l0ud/LooTunes/assets/assembled_pcb.jpg

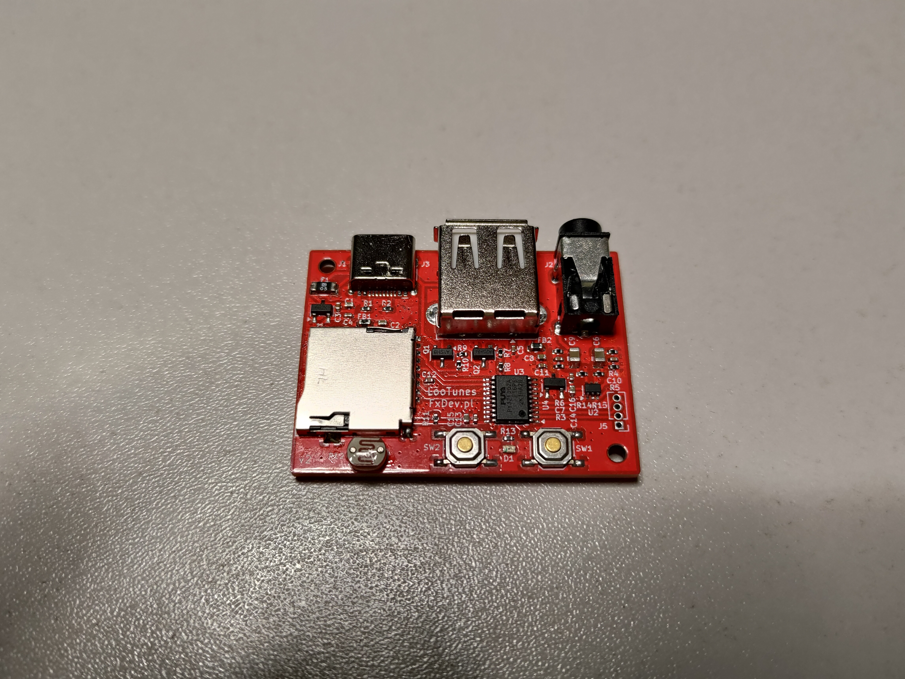
assets/assembled_pcb.jpg
