l0ud/LooTunes/assets/case.jpg

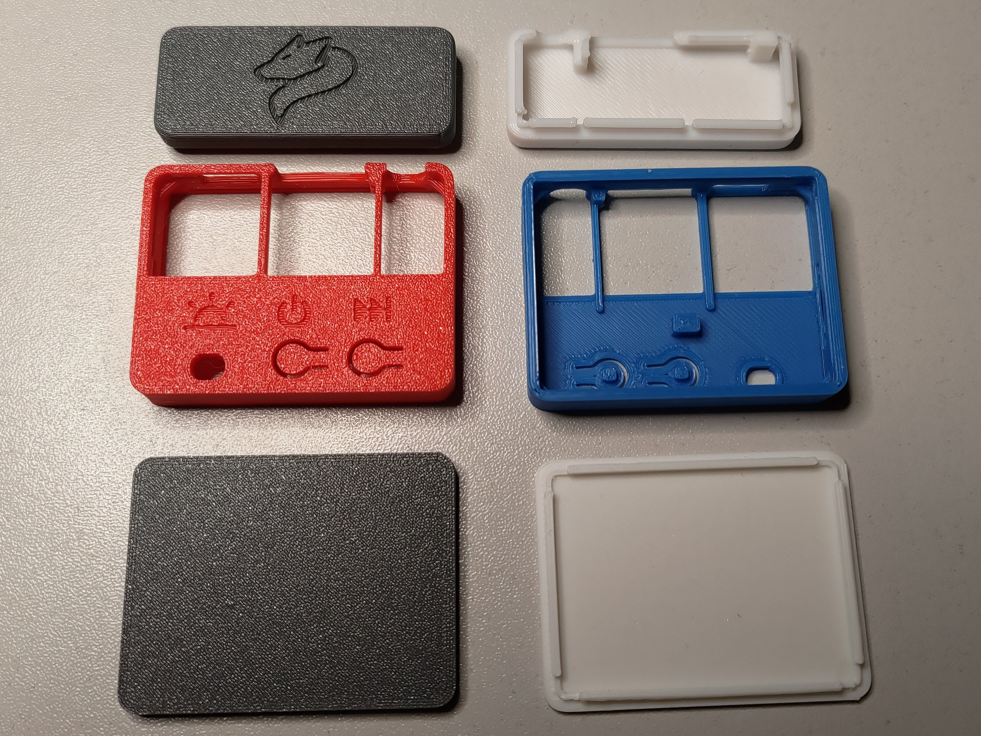
assets/case.jpg
