l0ud/LooTunes/assets/device.jpg

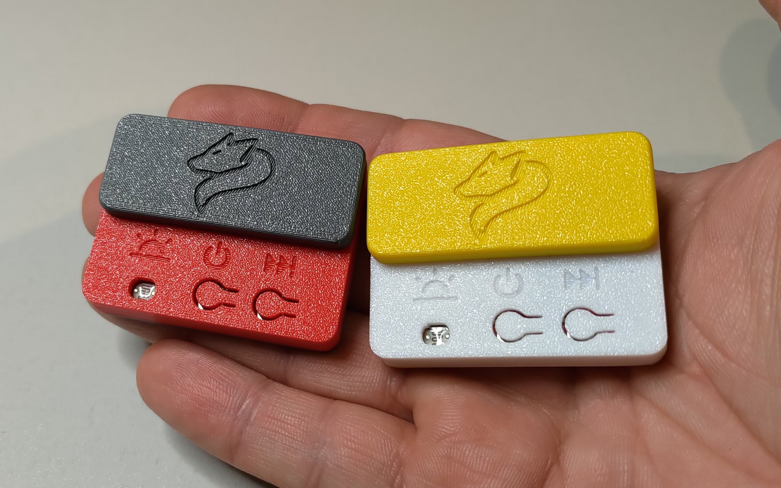
assets/device.jpg
