l0ud/LooTunes/assets/devices.jpg

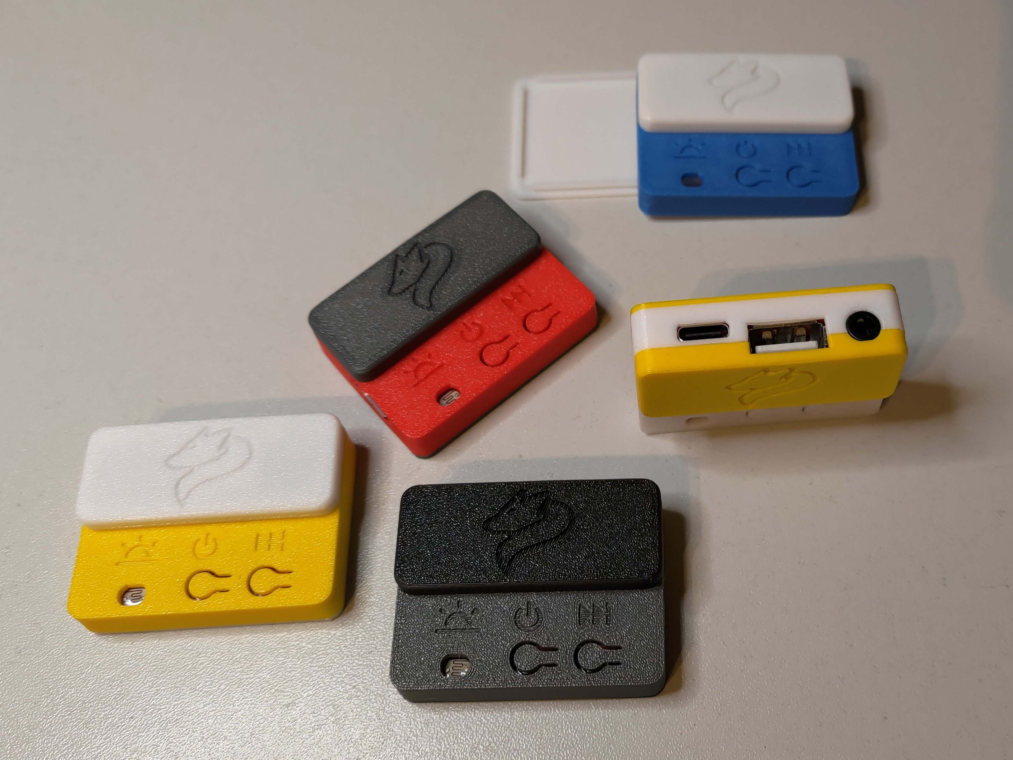
assets/devices.jpg
