l0ud/LooTunes/assets/pcb.jpg

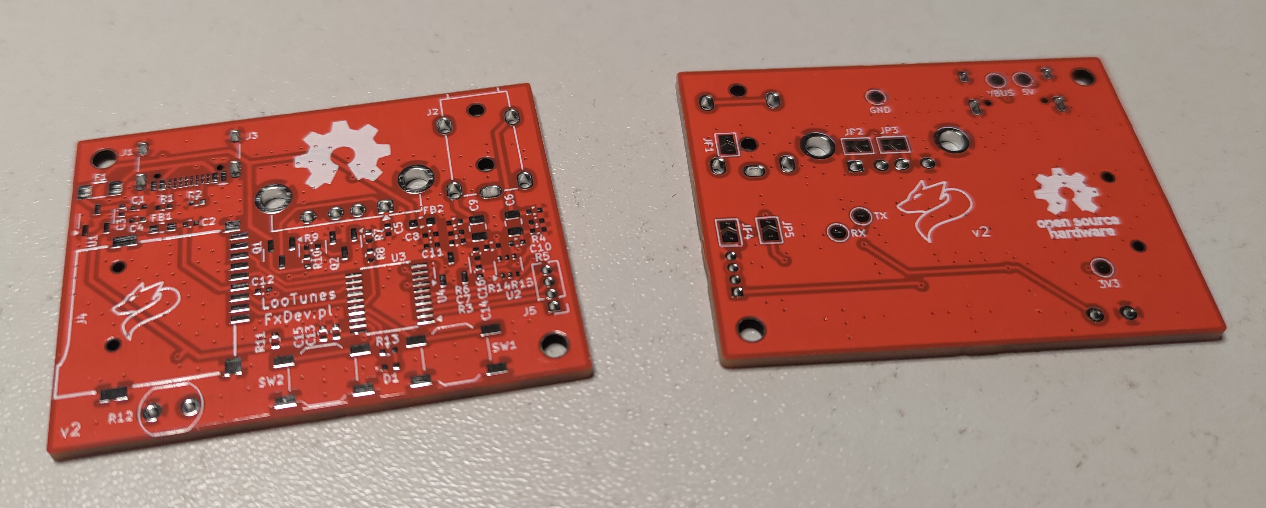
assets/pcb.jpg
