l0ud/LooTunes/assets/pcb_placed.jpg

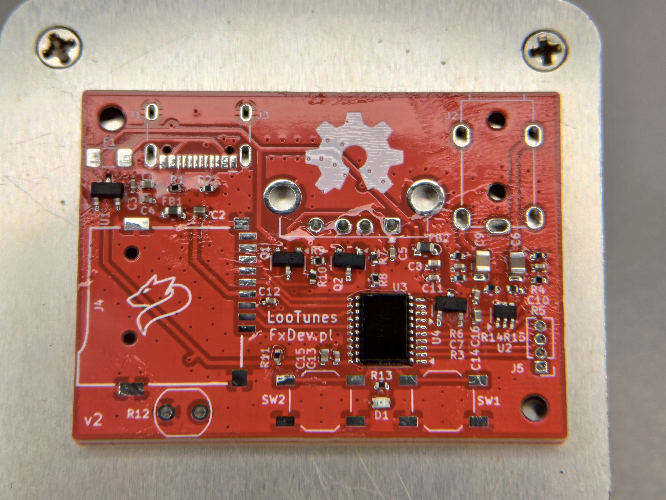
assets/pcb_placed.jpg
