l0ud/LooTunes/assets/pcb_tinned.jpg

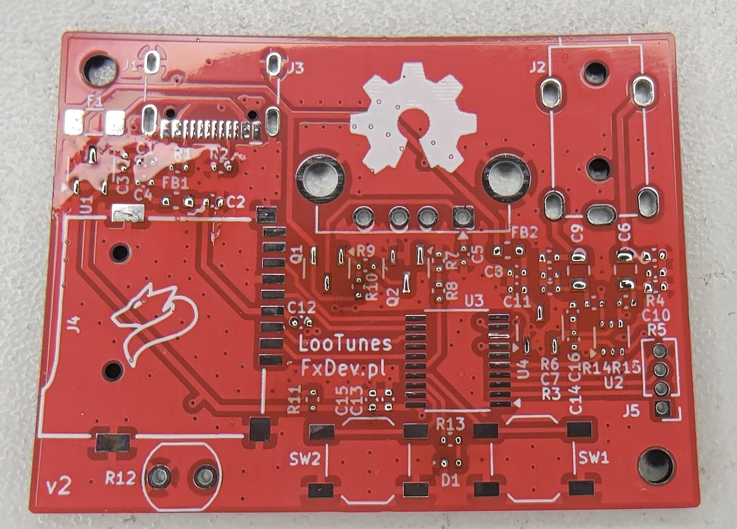
assets/pcb_tinned.jpg
