l0ud/LooTunes/assets/with_speakers.jpg

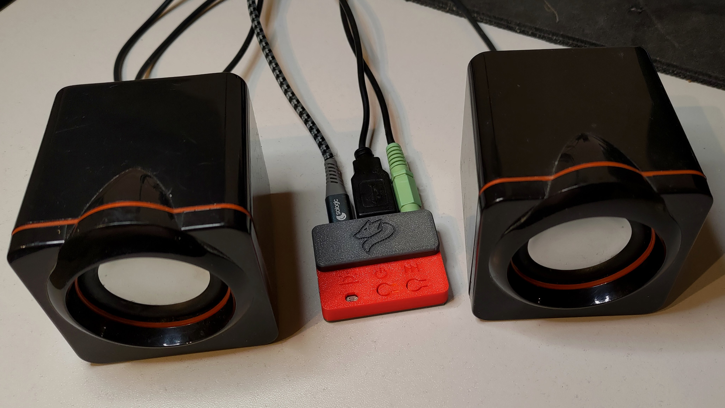
assets/with_speakers.jpg
