l0ud/LooTunes/case/base.stl

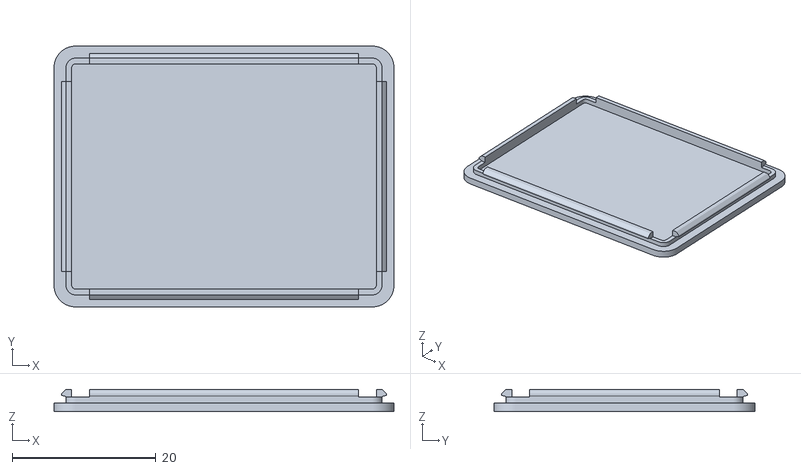
[picture p9: CAD file, 2025-11-18]
case/base.stl
47.3 x 36.3 x 3.09
