l0ud/LooTunes/case/body.stl

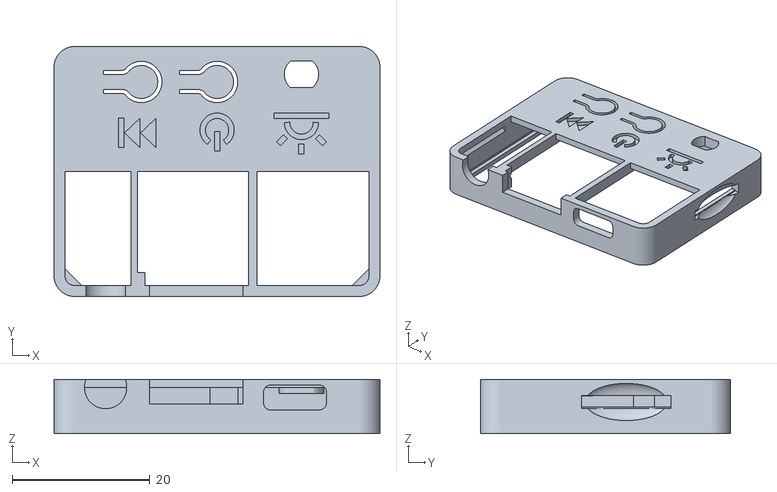
[picture p10: CAD file, 2025-11-18]
case/body.stl
47.3 x 36.3 x 7.88
