l0ud/LooTunes/case/cap.stl

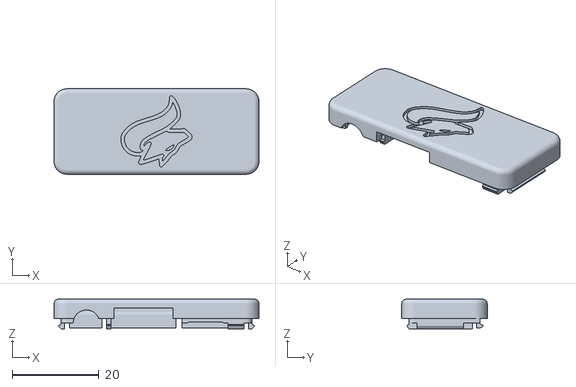
[picture p11: CAD file, 2025-11-18]
case/cap.stl
47.3 x 19.8 x 6.86
