l0ud/LooTunes/assets/schematics.pdf

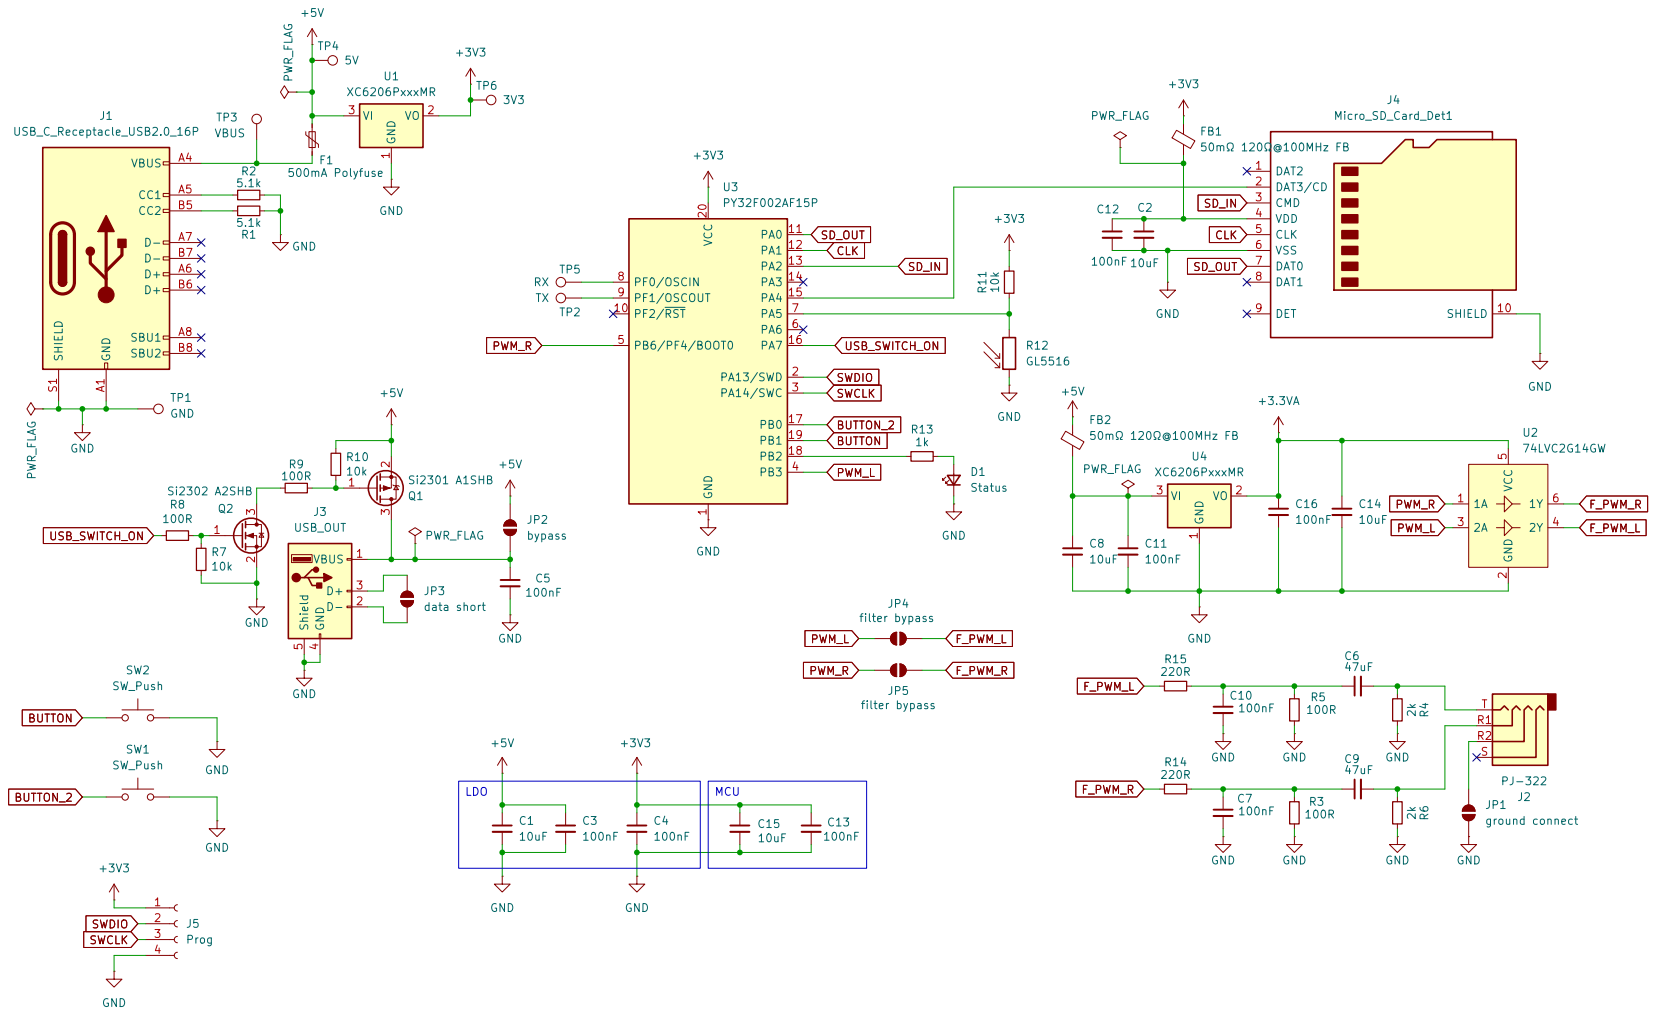
[picture p12: page 1]
