l0ud/LooTunes/hardware/FxLooTunes.kicad_pcb

## KiCad design hardware/FxLooTunes.kicad_pcb (2025-10-19)

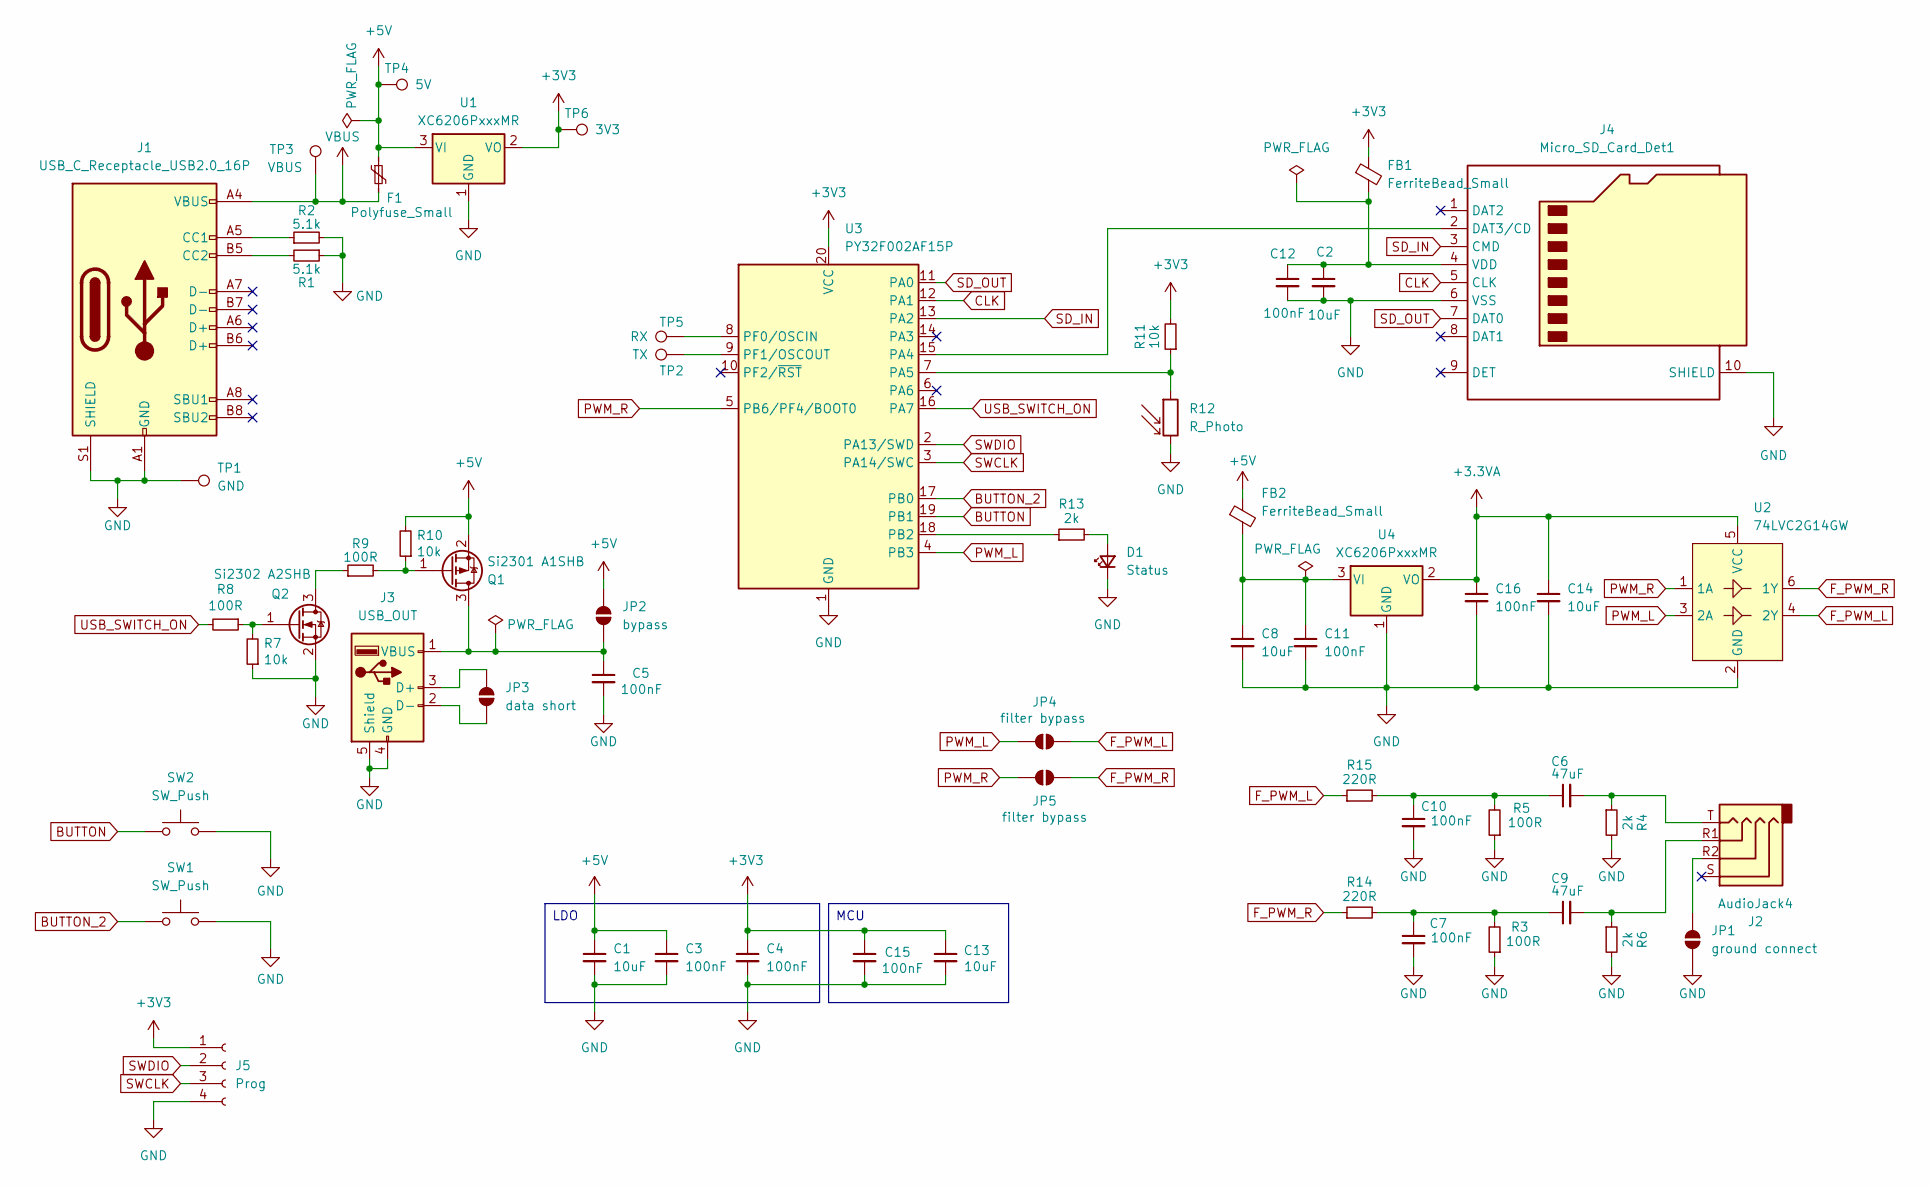
[picture p13: schematic FxLooTunes.kicad_sch]

Parts:
C1, C2, C8, C13, C14: 10uF; C_0402_1005Metric
C3, C4, C5, C7, C10, C11, C12, C15, C16: 100nF; C_0402_1005Metric
C6, C9: 47uF; C_0805_2012Metric
D1: Status; LED_0402_1005Metric
F1: Polyfuse_Small; Fuse_1206_3216Metric
FB1, FB2: FerriteBead_Small; L_0603_1608Metric
J1: USB_C_Receptacle_USB2.0_16P; USB_C_Receptacle_HCTL_HC-TYPE-C-16P-01A
J2: AudioJack4; PJ-322
J3: USB_OUT; USB_A_Connfly_DS1095
J4: Micro_SD_Card_Det1; GCT-MEM2055-00-190-01-A
J5: Prog; PinHeader_1x04_P1.27mm_Vertical
JP1: ground connect; SolderJumper-2_P1.3mm_Open_TrianglePad1.0x1.5mm
JP2: bypass; SolderJumper-2_P1.3mm_Open_TrianglePad1.0x1.5mm
JP3: data short; SolderJumper-2_P1.3mm_Open_TrianglePad1.0x1.5mm
JP4, JP5: filter bypass; SolderJumper-2_P1.3mm_Open_TrianglePad1.0x1.5mm
Q1: Si2301 A1SHB; SOT-23
Q2: Si2302 A2SHB; SOT-23
R1, R2: 5.1k; R_0402_1005Metric
R3, R5, R8, R9: 100R; R_0402_1005Metric
R4, R6, R13: 2k; R_0402_1005Metric
R7, R10, R11: 10k; R_0402_1005Metric
R12: R_Photo; R_LDR_5.0x4.1mm_P3mm_Vertical
R14, R15: 220R; R_0402_1005Metric
SW1, SW2: SW_Push; SW_SPST_TL3342
TP1: GND; TestPoint_Pad_D1.5mm
TP2: TX; TestPoint_Pad_D1.5mm
TP3: VBUS; TestPoint_Pad_D1.5mm
TP4: 5V; TestPoint_Pad_D1.5mm
TP5: RX; TestPoint_Pad_D1.5mm
TP6: 3V3; TestPoint_Pad_D1.5mm
U1, U4: XC6206PxxxMR; SOT-23-3
U2: 74LVC2G14GW; SOT-363_SC-70-6
U3: PY32F002AF15P; TSSOP-20_4.4x6.5mm_P0.65mm

Connections:
+3.3VA: C14.1, C16.1, U2.5 (VCC), U4.2 (VO)
+3V3: C4.1, C13.1, C15.1, FB1.1, J5.1, R11.2, TP6.1, U1.2 (VO), U3.20 (VCC)
BUTTON: SW2.1, U3.19 (PB1)
BUTTON_2: SW1.1, U3.17 (PB0)
CLK: J4.5 (CLK), U3.12 (PA1)
F_PWM_L: JP4.2 (B), R15.1, U2.4 (2Y)
F_PWM_R: JP5.2 (B), R14.1, U2.6 (1Y)
GND: C1.2, C2.2, C3.2, C4.2, C5.2, C7.2, C8.2, C10.2, C11.2, C12.2, C13.2, C14.2, C15.2, C16.2, D1.1 (K), J1.A1 (GND), J1.A12 (GND), J1.B1 (GND), J1.B12 (GND), J1.S1 (SHIELD), J3.4 (GND), J3.5 (Shield), J4.6 (VSS), J4.10 (SHIELD), J5.4, JP1.2 (B), Q2.2 (S), R1.1, R2.2, R3.1, R4.2, R5.1, R6.2, R7.1, R12.2, SW1.2, SW2.2, TP1.1, U1.1 (GND), U2.2 (GND), U3.1 (GND), U4.1 (GND)
unnamed: C6.1, C10.1, R5.2, R15.2
unnamed: C6.2, J2.T, R4.1
unnamed: C7.1, C9.1, R3.2, R14.2
unnamed: C9.2, J2.R1, R6.1
unnamed: D1.2 (A), R13.2
unnamed: J1.A5 (CC1), R2.1
unnamed: J1.B5 (CC2), R1.2
unnamed: J3.3 (D+), JP3.1 (A)
unnamed: J3.2 (D-), JP3.2 (B)
unnamed: J4.2 (DAT3/CD), U3.15 (PA4)
unnamed: C2.1, C12.1, FB1.2, J4.4 (VDD)
unnamed: J2.R2, JP1.1 (A)
unnamed: Q2.3 (D), R9.1
unnamed: Q2.1 (G), R7.2, R8.1
unnamed: Q1.1 (G), R9.2, R10.1
unnamed: R11.1, R12.1, U3.7 (PA5)
unnamed: R13.1, U3.18 (PB2)
unnamed: TP5.1, U3.8 (PF0/OSCIN)
unnamed: TP2.1, U3.9 (PF1/OSCOUT)
PWM_L: JP4.1 (A), U2.3 (2A), U3.4 (PB3)
PWM_R: JP5.1 (A), U2.1 (1A), U3.5 (PB6/PF4/BOOT0)
SD_IN: J4.3 (CMD), U3.13 (PA2)
SD_OUT: J4.7 (DAT0), U3.11 (PA0)
SWCLK: J5.3, U3.3 (PA14/SWC)
SWDIO: J5.2, U3.2 (PA13/SWD)
USB_SWITCH_IN: R8.2, U3.16 (PA7)
VBUS: F1.2, J1.A4 (VBUS), J1.A9 (VBUS), J1.B4 (VBUS), J1.B9 (VBUS), TP3.1

Notes on the sheet:
LDO
MCU

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
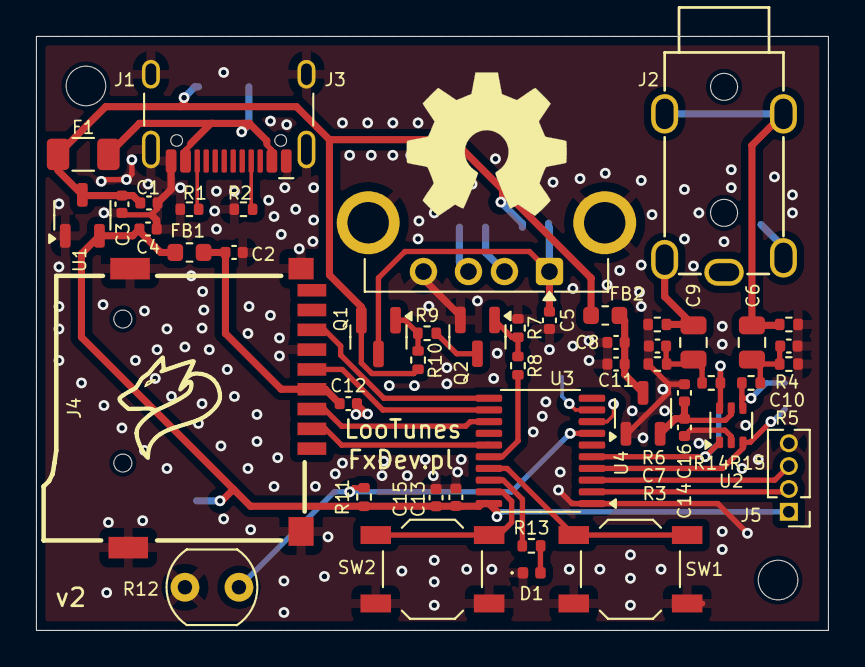
[picture p14: board FxLooTunes.kicad_pcb from above]

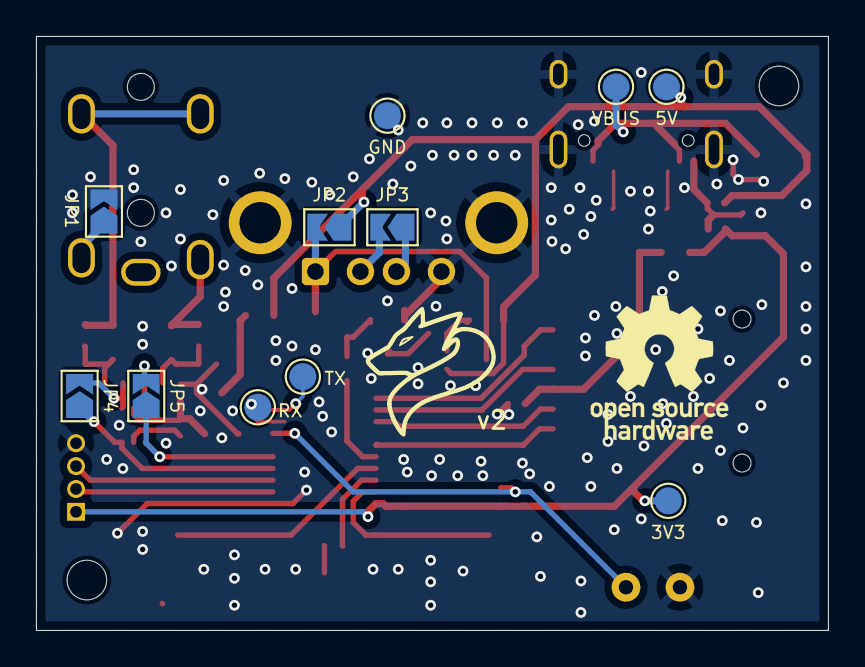
[picture p15: board FxLooTunes.kicad_pcb from below]

Board: 2 copper layers, 44.0 x 33.0 mm, 59 parts (11 on the bottom side), 38 nets.
