l0ud/LooTunes/hardware/FxLooTunesv1.kicad_pcb

## KiCad design hardware/FxLooTunesv1.kicad_pcb (2025-10-19)

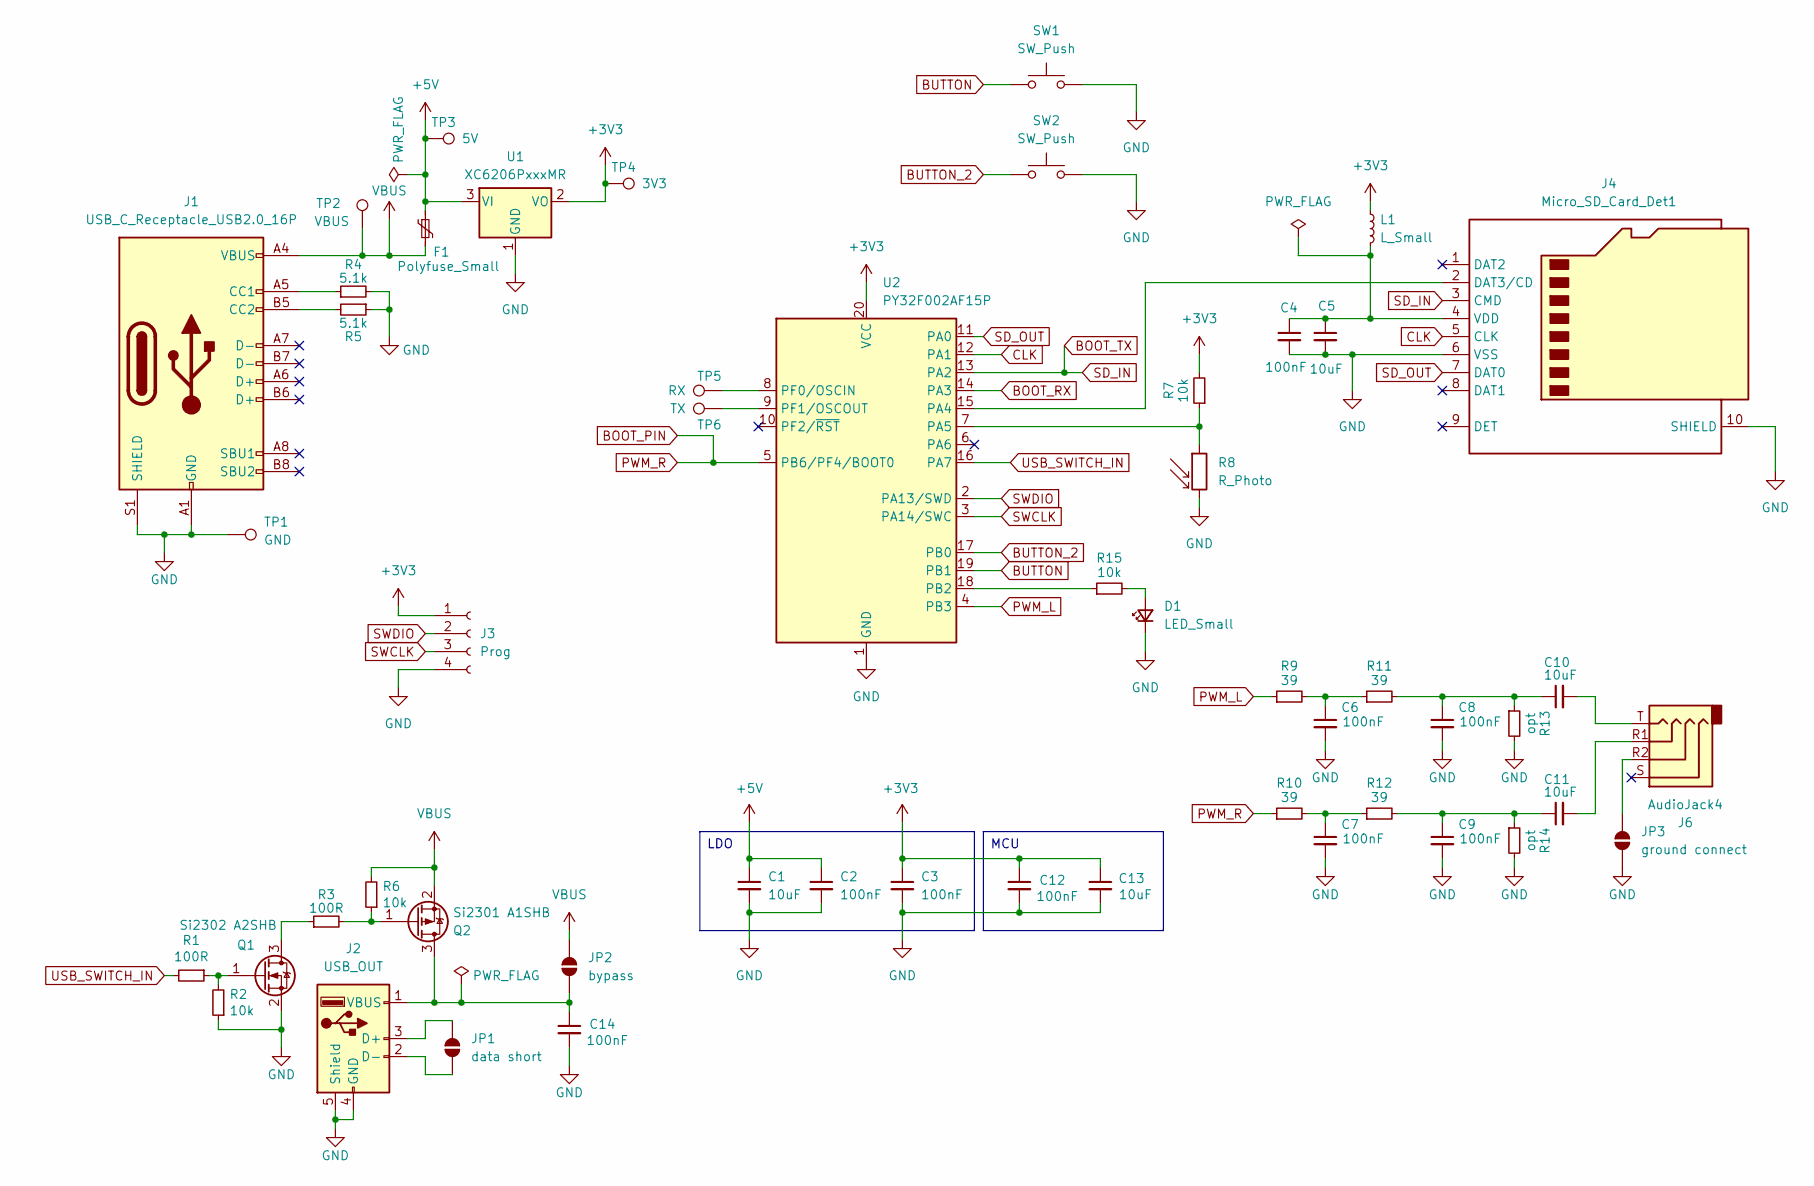
[picture p16: schematic FxLooTunesv1.kicad_sch]

Parts:
C1, C5, C10, C11, C13: 10uF; C_0402_1005Metric
C2, C3, C4, C6, C7, C8, C9, C12, C14: 100nF; C_0402_1005Metric
D1: LED_Small; LED_0402_1005Metric
F1: Polyfuse_Small; Fuse_1206_3216Metric
J1: USB_C_Receptacle_USB2.0_16P; USB_C_Receptacle_HCTL_HC-TYPE-C-16P-01A
J2: USB_OUT; USB_A_Connfly_DS1095
J3: Prog; PinHeader_1x04_P1.27mm_Vertical
J4: Micro_SD_Card_Det1; GCT-MEM2055-00-190-01-A
J6: AudioJack4; PJ-322
JP1: data short; SolderJumper-2_P1.3mm_Open_TrianglePad1.0x1.5mm
JP2: bypass; SolderJumper-2_P1.3mm_Open_TrianglePad1.0x1.5mm
JP3: ground connect; SolderJumper-2_P1.3mm_Open_TrianglePad1.0x1.5mm
L1: L_Small; L_0402_1005Metric
Q1: Si2302 A2SHB; SOT-23
Q2: Si2301 A1SHB; SOT-23
R1, R3: 100R; R_0402_1005Metric
R2, R6, R7, R15: 10k; R_0402_1005Metric
R4, R5: 5.1k; R_0402_1005Metric
R8: R_Photo; R_LDR_5.0x4.1mm_P3mm_Vertical
R9, R10, R11, R12: 39; R_0402_1005Metric
R13, R14: opt; R_0402_1005Metric
SW1, SW2: SW_Push; SW_SPST_TL3342
TP1: GND; TestPoint_Pad_D1.5mm
TP2: VBUS; TestPoint_Pad_D1.5mm
TP3: 5V; TestPoint_Pad_D1.5mm
TP4: 3V3; TestPoint_Pad_D1.5mm
TP5: RX; TestPoint_Pad_D1.5mm
TP6: TX; TestPoint_Pad_D1.5mm
U1: XC6206PxxxMR; SOT-23-3
U2: PY32F002AF15P; TSSOP-20_4.4x6.5mm_P0.65mm

Connections:
+3V3: C3.1, C12.1, C13.1, J3.1, L1.1, R7.2, TP4.1, U1.2 (VO), U2.20 (VCC)
BOOT_PIN: R10.1, U2.5 (PB6/PF4/BOOT0)
BOOT_RX: U2.14 (PA3)
BOOT_TX: J4.3 (CMD), U2.13 (PA2)
BUTTON: SW1.1, U2.19 (PB1)
BUTTON_2: SW2.1, U2.17 (PB0)
CLK: J4.5 (CLK), U2.12 (PA1)
GND: C1.2, C2.2, C3.2, C4.2, C5.2, C6.2, C7.2, C8.2, C9.2, C12.2, C13.2, C14.2, D1.1 (K), J1.A1 (GND), J1.A12 (GND), J1.B1 (GND), J1.B12 (GND), J1.S1 (SHIELD), J2.4 (GND), J2.5 (Shield), J3.4, J4.6 (VSS), J4.10 (SHIELD), JP3.2 (B), Q1.2 (S), R2.1, R4.2, R5.1, R8.2, R13.2, R14.2, SW1.2, SW2.2, TP1.1, U1.1 (GND), U2.1 (GND)
unnamed: C6.1, R9.2, R11.1
unnamed: C7.1, R10.2, R12.1
unnamed: C8.1, C10.1, R11.2, R13.1
unnamed: C10.2, J6.T
unnamed: C9.1, C11.1, R12.2, R14.1
unnamed: C11.2, J6.R1
unnamed: D1.2 (A), R15.2
unnamed: J1.A5 (CC1), R4.1
unnamed: J1.B5 (CC2), R5.2
unnamed: J2.3 (D+), JP1.1 (A)
unnamed: J2.2 (D-), JP1.2 (B)
unnamed: J4.2 (DAT3/CD), U2.15 (PA4)
unnamed: C4.1, C5.1, J4.4 (VDD), L1.2
unnamed: J6.R2, JP3.1 (A)
unnamed: Q1.3 (D), R3.1
unnamed: Q1.1 (G), R1.1, R2.2
unnamed: Q2.1 (G), R3.2, R6.1
unnamed: R7.1, R8.1, U2.7 (PA5)
unnamed: R15.1, U2.18 (PB2)
unnamed: TP5.1, U2.8 (PF0/OSCIN)
unnamed: TP6.1, U2.9 (PF1/OSCOUT)
PWM_L: R9.1, U2.4 (PB3)
SD_OUT: J4.7 (DAT0), U2.11 (PA0)
SWCLK: J3.3, U2.3 (PA14/SWC)
SWDIO: J3.2, U2.2 (PA13/SWD)
USB_SWITCH_IN: R1.2, U2.16 (PA7)
VBUS: F1.2, J1.A4 (VBUS), J1.A9 (VBUS), J1.B4 (VBUS), J1.B9 (VBUS), JP2.1 (A), Q2.2 (S), R6.2, TP2.1

Notes on the sheet:
LDO
MCU

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
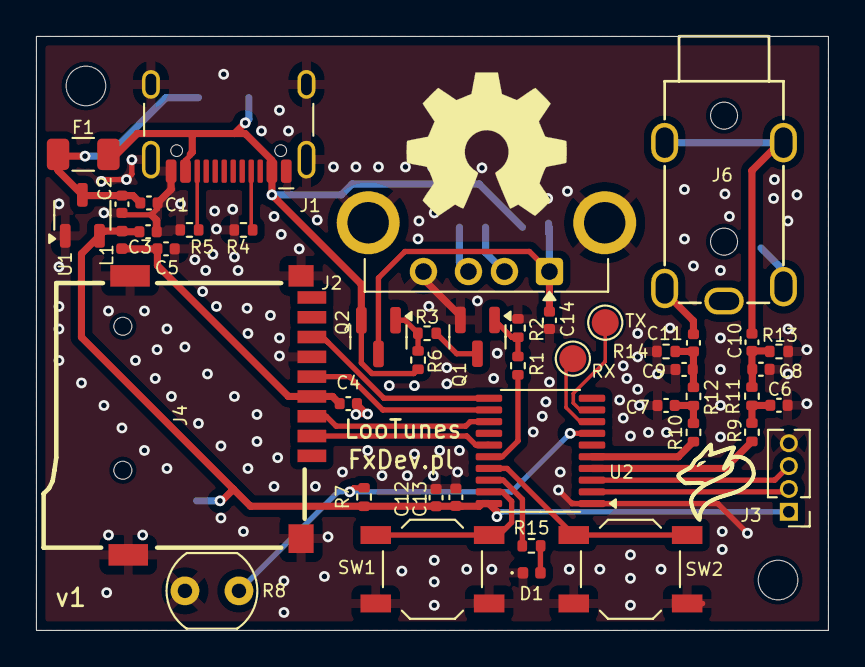
[picture p17: board FxLooTunesv1.kicad_pcb from above]

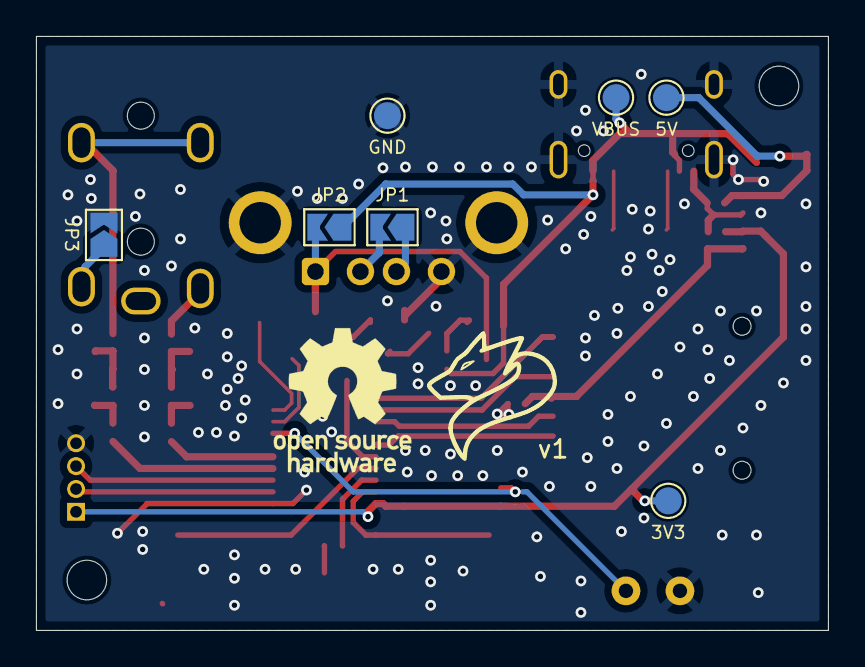
[picture p18: board FxLooTunesv1.kicad_pcb from below]

Board: 2 copper layers, 44.0 x 33.0 mm, 52 parts (7 on the bottom side), 36 nets.
