l0ud/LooTunes/firmware/HAL/include/py32f0xx_hal.h

/**
  ******************************************************************************
  * @file    py32f0xx_hal.h
  * @author  MCU Application Team
  * @brief   This file contains all the functions prototypes for the HAL
  *          module driver.
  ******************************************************************************
  * @attention
  *
  * <h2><center>&copy; Copyright (c) Puya Semiconductor Co.
  * All rights reserved.</center></h2>
  *
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
  ******************************************************************************
  */

/* Define to prevent recursive inclusion -------------------------------------*/
#ifndef __PY32F0xx_HAL_H
#define __PY32F0xx_HAL_H

#ifdef __cplusplus
extern "C" {
#endif

/* Includes ------------------------------------------------------------------*/
#include "py32f0xx_hal_conf.h"

/** @addtogroup PY32F0xx_HAL_Driver
  * @{
  */

/** @addtogroup HAL
  * @{
  */

/* Exported constants --------------------------------------------------------*/

/** @defgroup HAL_Exported_Constants HAL Exported Constants
  * @{
  */

/** @defgroup HAL_TICK_FREQ Tick Frequency
  * @{
  */
typedef enum
{
  HAL_TICK_FREQ_10HZ         = 100U,
  HAL_TICK_FREQ_100HZ        = 10U,
  HAL_TICK_FREQ_1KHZ         = 1U,
  HAL_TICK_FREQ_DEFAULT      = HAL_TICK_FREQ_1KHZ
} HAL_TickFreqTypeDef;
/**
  * @}
  */
/* Exported types ------------------------------------------------------------*/
extern uint32_t uwTickPrio;
extern uint32_t uwTickFreq;
/** @defgroup SYSCFG_Exported_Constants SYSCFG Exported Constants
  * @{
  */

/** @defgroup SYSCFG_BootMode Boot Mode
  * @{
  */
#define SYSCFG_BOOT_MAINFLASH          0x00000000U                      /*!< Main Flash memory mapped at 0x0000 0000   */
#define SYSCFG_BOOT_SYSTEMFLASH        SYSCFG_CFGR1_MEM_MODE_0          /*!< System Flash memory mapped at 0x0000 0000 */
#define SYSCFG_BOOT_SRAM               (SYSCFG_CFGR1_MEM_MODE_1 | SYSCFG_CFGR1_MEM_MODE_0)  /*!< Embedded SRAM mapped at 0x0000 0000 */

/**
  * @}
  */
/* Exported macro ------------------------------------------------------------*/
/** @defgroup HAL_Exported_Macros HAL Exported Macros
  * @{
  */

/** @defgroup DBGMCU_Freeze_Unfreeze Freeze Unfreeze Peripherals in Debug mode
  * @brief   Freeze/Unfreeze Peripherals in Debug mode
  * Note:
  *       Debug registers DBGMCU_IDCODE and DBGMCU_CR are accessible only in
  *       debug mode (not accessible by the user software in normal mode).
  *       Refer to errata sheet of these devices for more details.
  * @{
  */

/* Peripherals on APB1 */

/* Exported macros -----------------------------------------------------------*/
/** @defgroup HAL_Exported_Macros HAL Exported Macros
  * @{
  */

/** @defgroup HAL_Freeze_Unfreeze_Peripherals HAL Freeze Unfreeze Peripherals
  * @brief  Freeze/Unfreeze Peripherals in Debug mode
  * @{
  */



#if defined(DBGMCU_APB_FZ1_DBG_RTC_STOP)
#define __HAL_DBGMCU_FREEZE_RTC()            (DBGMCU->APBFZ1 |= (DBGMCU_APB_FZ1_DBG_RTC_STOP))
#define __HAL_DBGMCU_UNFREEZE_RTC()          (DBGMCU->APBFZ1 &= ~(DBGMCU_APB_FZ1_DBG_RTC_STOP))
#endif /* DBGMCU_APB_FZ_DBG_RTC_STOP */

#if defined(DBGMCU_APB_FZ1_DBG_I2C_SMBUS_TIMEOUT)
#define __HAL_DBGMCU_FREEZE_I2C_TIMEOUT()   (DBGMCU->APBFZ1 |= (DBGMCU_APB_FZ1_DBG_I2C_SMBUS_TIMEOUT))
#define __HAL_DBGMCU_UNFREEZE_I2C_TIMEOUT() (DBGMCU->APBFZ1 &= ~(DBGMCU_APB_FZ1_DBG_I2C_SMBUS_TIMEOUT))
#endif /* DBGMCU_APB_FZ_DBG_I2C_SMBUS_TIMEOUT */

#if defined(DBGMCU_APB_FZ1_DBG_IWDG_STOP)
#define __HAL_DBGMCU_FREEZE_IWDG()           (DBGMCU->APBFZ1 |= (DBGMCU_APB_FZ1_DBG_IWDG_STOP))
#define __HAL_DBGMCU_UNFREEZE_IWDG()         (DBGMCU->APBFZ1 &= ~(DBGMCU_APB_FZ1_DBG_IWDG_STOP))
#endif /* DBGMCU_APB_FZ_DBG_IWDG_STOP */

#if defined(DBGMCU_APB_FZ1_DBG_WWDG_STOP)
#define __HAL_DBGMCU_FREEZE_WWDG()           (DBGMCU->APBFZ1 |= (DBGMCU_APB_FZ1_DBG_WWDG_STOP))
#define __HAL_DBGMCU_UNFREEZE_WWDG()         (DBGMCU->APBFZ1 &= ~(DBGMCU_APB_FZ1_DBG_WWDG_STOP))
#endif /* DBGMCU_APB_FZ_DBG_WWDG_STOP */

#if defined(DBGMCU_APB_FZ1_DBG_TIM2_STOP)
#define __HAL_DBGMCU_FREEZE_TIM2()           (DBGMCU->APBFZ1 |= (DBGMCU_APB_FZ1_DBG_TIM2_STOP))
#define __HAL_DBGMCU_UNFREEZE_TIM2()         (DBGMCU->APBFZ1 &= ~(DBGMCU_APB_FZ1_DBG_TIM2_STOP))
#endif /* DBGMCU_APB_FZ_DBG_TIM2_STOP */

#if defined(DBGMCU_APB_FZ1_DBG_TIM3_STOP)
#define __HAL_DBGMCU_FREEZE_TIM3()           (DBGMCU->APBFZ1 |= (DBGMCU_APB_FZ1_DBG_TIM3_STOP))
#define __HAL_DBGMCU_UNFREEZE_TIM3()         (DBGMCU->APBFZ1 &= ~(DBGMCU_APB_FZ1_DBG_TIM3_STOP))
#endif /* DBGMCU_APB_FZ_DBG_TIM3_STOP */

#if defined(DBGMCU_APB_FZ1_DBG_TIM6_STOP)
#define __HAL_DBGMCU_FREEZE_TIM6()           (DBGMCU->APBFZ1 |= (DBGMCU_APB_FZ1_DBG_TIM6_STOP))
#define __HAL_DBGMCU_UNFREEZE_TIM6()         (DBGMCU->APBFZ1 &= ~(DBGMCU_APB_FZ1_DBG_TIM6_STOP))
#endif /* DBGMCU_APB_FZ_DBG_TIM6_STOP */
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
