l0ud/LooTunes/(commit log)

2025-08-04 working sbc player with light detection and button support
2025-08-24 insert padding after non-data command for some SDs. Do not reinitialize fs on main.
2025-09-05 directory support, changed flow to handle errors better, faster file opening, plans for new config params.
    [button.cpp, button.h, config.cpp, config.h, main.cpp]
2025-09-09 random playback with position save WIP, buggy
    [config.cpp, config.h, feistel.cpp, feistel.h, main.cpp]
2025-09-13 added missing files, try to split sequencial and random playback
    [main.cpp]
2025-09-16 off-by-one bugfix, state should not accumulate increasing dir number, some simplifications
    [config.cpp, config.h, playback_state.cpp, playback_state.h]
2025-10-03 test: 10bit audio in the cost of lower (22kHz) pwm carrier
2025-10-06 fade in and fade out support. Simplification: never actually stop pwm to avoid popping noise
    [audio_player.cpp, audio_player.h, config.cpp, config.h, controller.cpp, playback_state.h]
2025-10-09 fix undefined startup state
    [audio_player.cpp, audio_player.h, controller.cpp]
2025-10-10 do not save state during playback (when not muted). Eliminate pops after mode button press
2025-10-19 add hardware dir, removed gui accidently copy pasted from other project
    [FxLooTunes.kicad_pcb, FxLooTunes.kicad_sch, FxLooTunesv1.kicad_pcb, FxLooTunesv1.kicad_sch]
2025-10-20 cleanup and modernize config reader. Fix project name and workspace settings
    [config.cpp]
2025-10-21 add support for standard capacity cards
2025-11-15 update schematics, remove watchdog remainings and workarounds
    [FxLooTunes.kicad_sch]
2025-11-18 bugfix: do not start from fade-out on power on
    [controller.cpp]
2025-11-18 add some assets
    [base.stl, body.stl, cap.stl]
